ese5160/a14g-final-submission-t26-circuit-crusaders/images/back_view_helmat_3.jpg

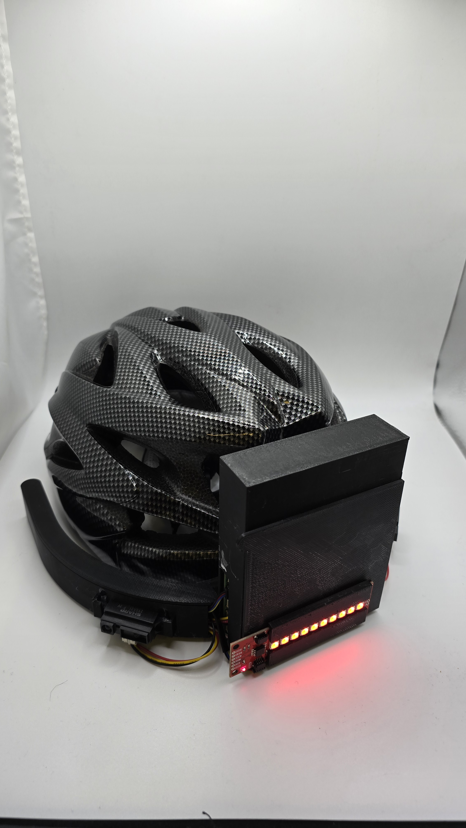
images/back_view_helmat_3.jpg
