ese5160/a14g-final-submission-t26-circuit-crusaders/images/side_view_with_helmet.jpg

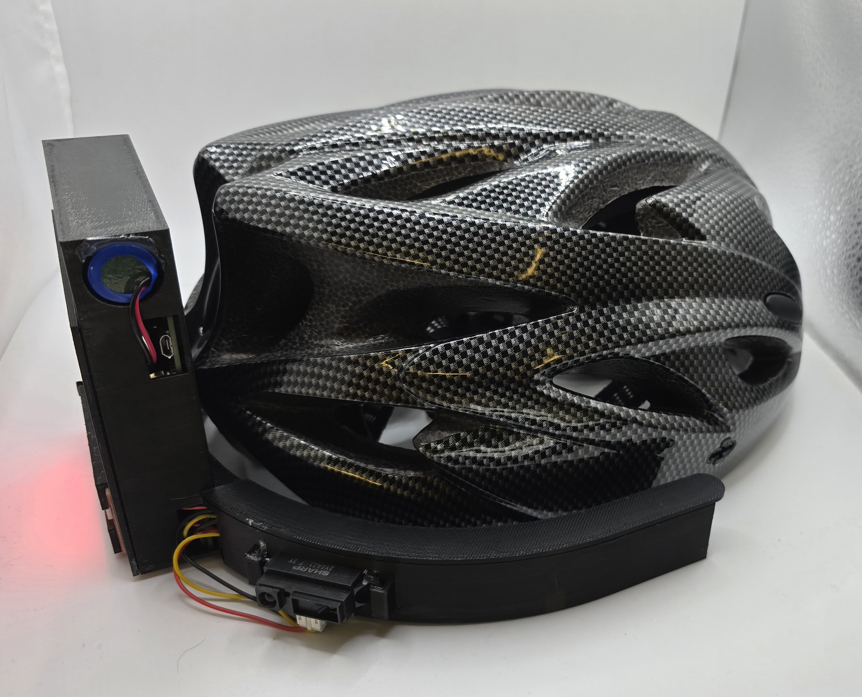
images/side_view_with_helmet.jpg
