ese5160/a14g-final-submission-t26-circuit-crusaders/(commit log)

2024-05-03 ir sensors
2024-05-03 led strop
2024-05-03 Circuit Photos
2024-05-04 Part 2 is done but need to add Device Diagram
2024-05-04 Part 2 is done but need to add Device Diagrammmm
